Prthm-G/Single-Axis-MEMS-Accelerometer/FEA/Static and Modal Analysis/MEMS_1-Static 3-1.docx

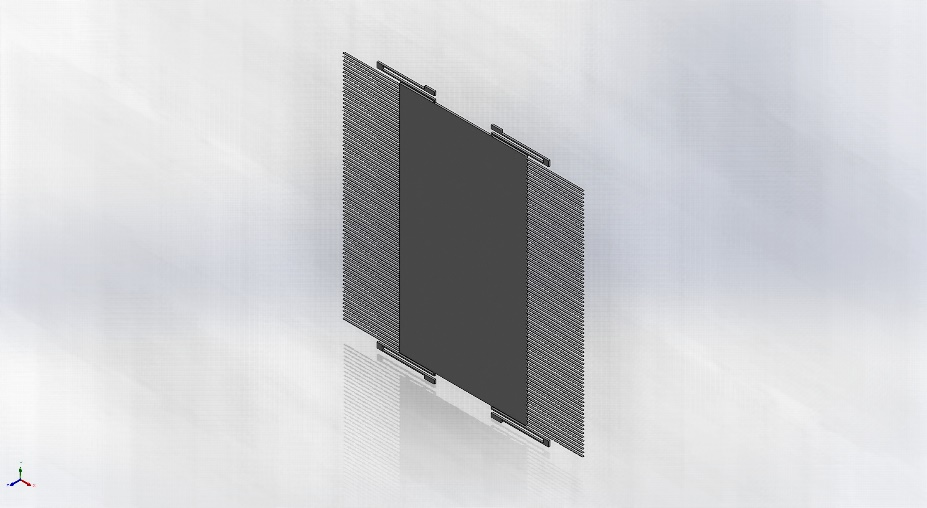
[picture p1: figure]

Simulation of MEMS_1

Date: Monday, December 4, 2023
Designer: Solidworks

Study name: Static 3

Analysis type: Static
Description No Data

# Assumptions

# Model Information

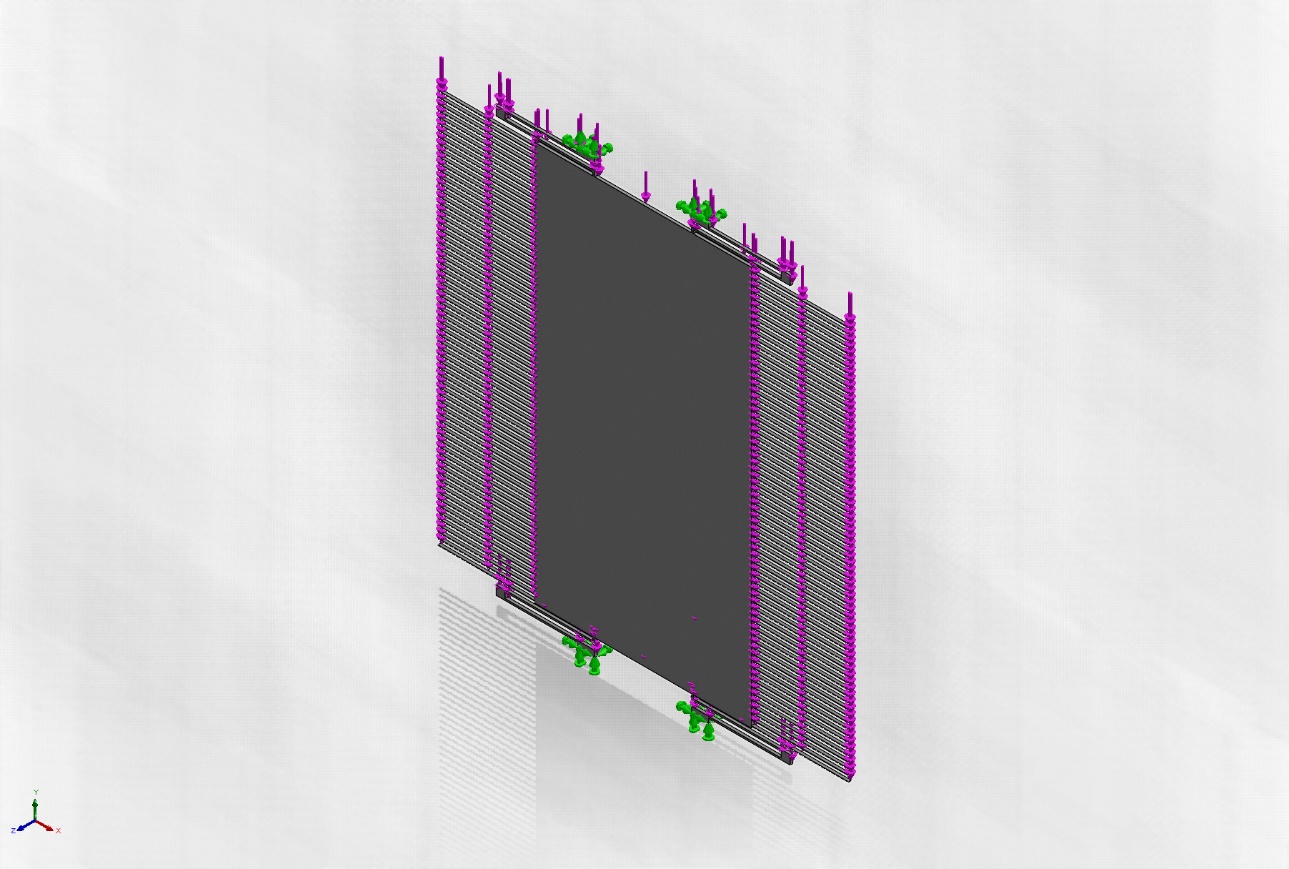
[picture p2: figure]

Model name: MEMS_1

Current Configuration: Default

Solid Bodies
Document Name and Reference | Treated As | Volumetric Properties | Document Path/Date Modified
MEMS_1.dwg<1> | Solid Body | Mass:4.30502e-10 kg Volume:1.84765e-10 m^3 Density:2.33 kg/m^3 Weight:4.21892e-09 N | C:\Users\241pr\OneDrive - UBC\Desktop\Apps\UBC\ELEC 465\Project\FEA\MEMS_1.SLDPRT Dec 4 13:18:33 2023

# Study Properties

Study name | Static 3
Analysis type | Static
Mesh type | Solid Mesh
Thermal Effect: | On
Thermal option | Include temperature loads
Zero strain temperature | 298 Kelvin
Include fluid pressure effects from SOLIDWORKS Flow Simulation | Off
Solver type | Automatic
Inplane Effect: | Off
Soft Spring: | Off
Inertial Relief: | Off
Incompatible bonding options | Automatic
Large displacement | Off
Compute free body forces | On
Friction | Off
Use Adaptive Method: | Off
Result folder | SOLIDWORKS document (C:\Users\241pr\OneDrive - UBC\Desktop\Apps\UBC\ELEC 465\Project\FEA)

# Units

Unit system: | SI (MKS)
Length/Displacement | mm
Temperature | Kelvin
Angular velocity | Rad/sec
Pressure/Stress | N/m^2

# Material Properties

Model Reference | Properties | Components

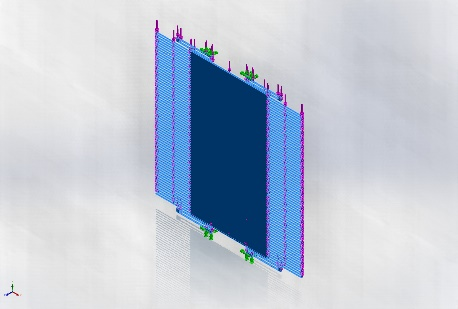
[picture p3: figure]

| Name: Custom Plastic Model type: Linear Elastic Isotropic Default failure criterion: Unknown Elastic modulus: 1.7e+11 N/m^2 Poisson's ratio: 0.29 Mass density: 2.33 kg/m^3 Thermal expansion coefficient: 2.6e-06 /Kelvin | SolidBody 1(MEMS_1.dwg<1>)(MEMS_1)

Curve Data:N/A

# Loads and Fixtures

Fixture name | Fixture Image | Fixture Details

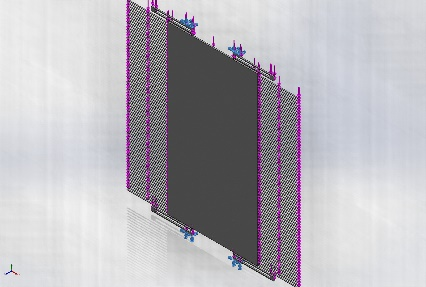
[picture p4: figure]

Fixed-1 | | Entities: 4 face(s) Type: Fixed Geometry

Resultant Forces

Components | X | Y | Z | Resultant
Reaction force(N) | 2.78533e-12 | 9.81e-06 | 1.25056e-12 | 9.81e-06
Reaction Moment(N.m) | 0 | 0 | 0 | 0

Load name | Load Image | Load Details

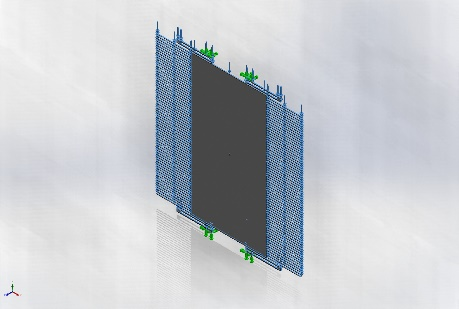
[picture p5: figure]

Force-1 | | Entities: 1 face(s) Type: Apply force Values: ---, -9.81e-06, --- N

# Connector Definitions

No Data

# Interaction Information

No Data

# Mesh information

Mesh type | Solid Mesh
Mesher Used: | Blended curvature-based mesh
Jacobian points for High quality mesh | 16 Points
Maximum element size | 0.00363897 in
Minimum element size | 0.00363897 in
Mesh Quality | High

## Mesh information - Details

Total Nodes | 41336
Total Elements | 17143
Maximum Aspect Ratio | 54.758
% of elements with Aspect Ratio < 3 | 5.69
Percentage of elements with Aspect Ratio > 10 | 53.5
Percentage of distorted elements | 0
Time to complete mesh(hh;mm;ss): | 00:00:13
Computer name: | RAZER-BLADE

# Sensor Details

No Data

# Resultant Forces

## Reaction forces

Selection set | Units | Sum X | Sum Y | Sum Z | Resultant
Entire Model | N | 2.78533e-12 | 9.81e-06 | 1.25056e-12 | 9.81e-06

## Reaction Moments

Selection set | Units | Sum X | Sum Y | Sum Z | Resultant
Entire Model | N.m | 0 | 0 | 0 | 0

## Free body forces

Selection set | Units | Sum X | Sum Y | Sum Z | Resultant
Entire Model | N | -2.27041e-11 | 1.85319e-09 | 8.51558e-12 | 1.85335e-09

## Free body moments

Selection set | Units | Sum X | Sum Y | Sum Z | Resultant
Entire Model | N.m | 0 | 0 | 0 | 1e-33

# Beams

No Data

# Study Results

Name | Type | Min | Max
Stress1 | VON: von Mises Stress | 1.122e+00N/m^2 Node: 27919 | 8.623e+05N/m^2 Node: 905

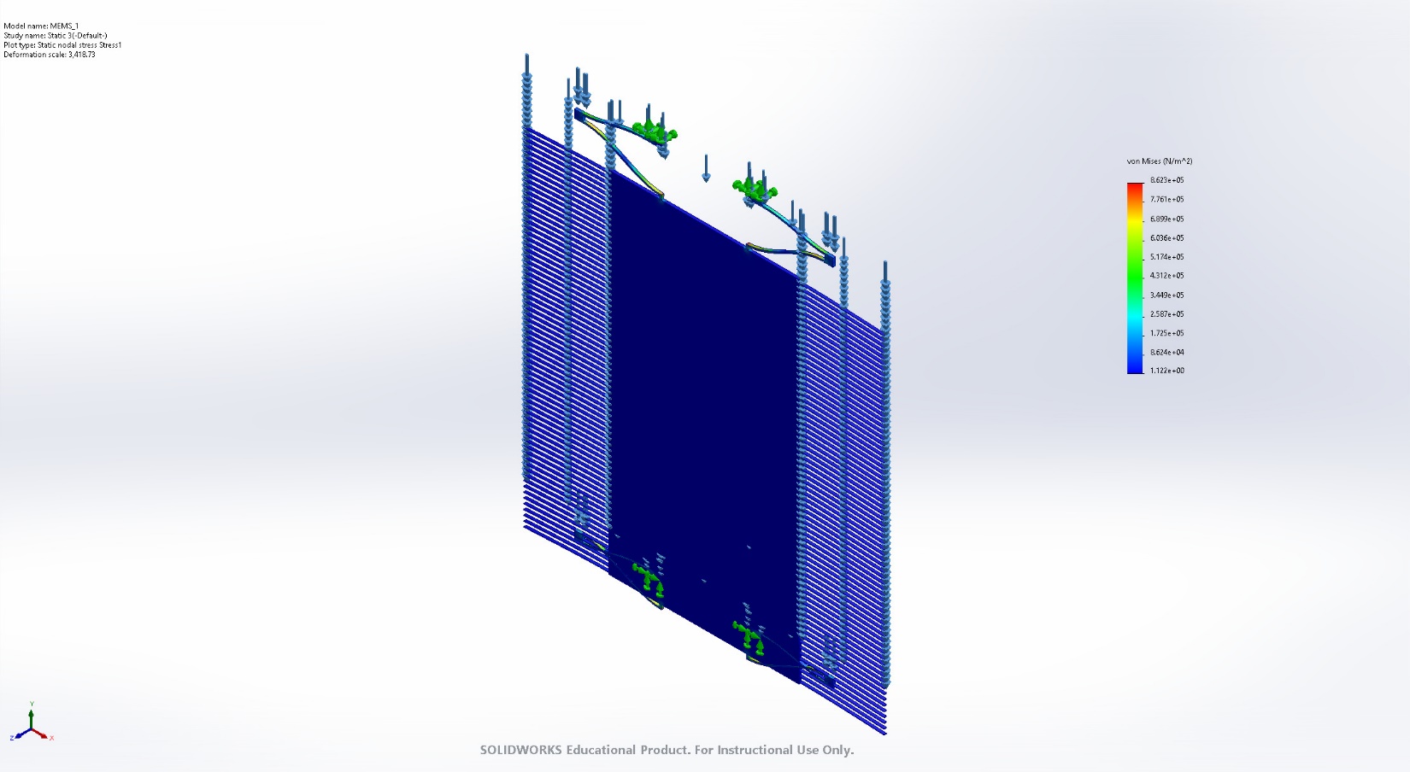
[picture p6: figure]

MEMS_1-Static 3-Stress-Stress1

Name | Type | Min | Max
Displacement1 | URES: Resultant Displacement | 0.000e+00mm Node: 8 | 1.112e-04mm Node: 579

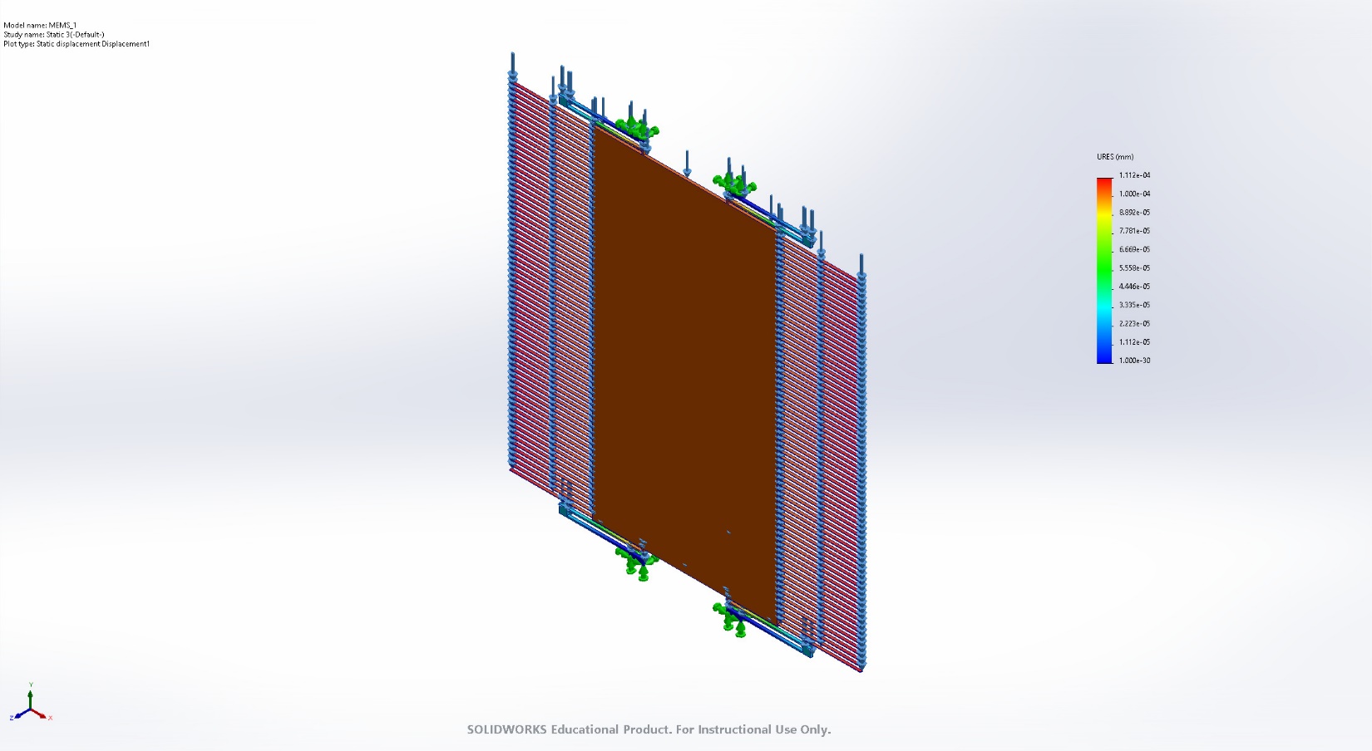
[picture p7: figure]

MEMS_1-Static 3-Displacement-Displacement1

Name | Type | Min | Max
Strain1 | ESTRN: Equivalent Strain | 5.837e-12 Element: 14689 | 2.776e-06 Element: 4347

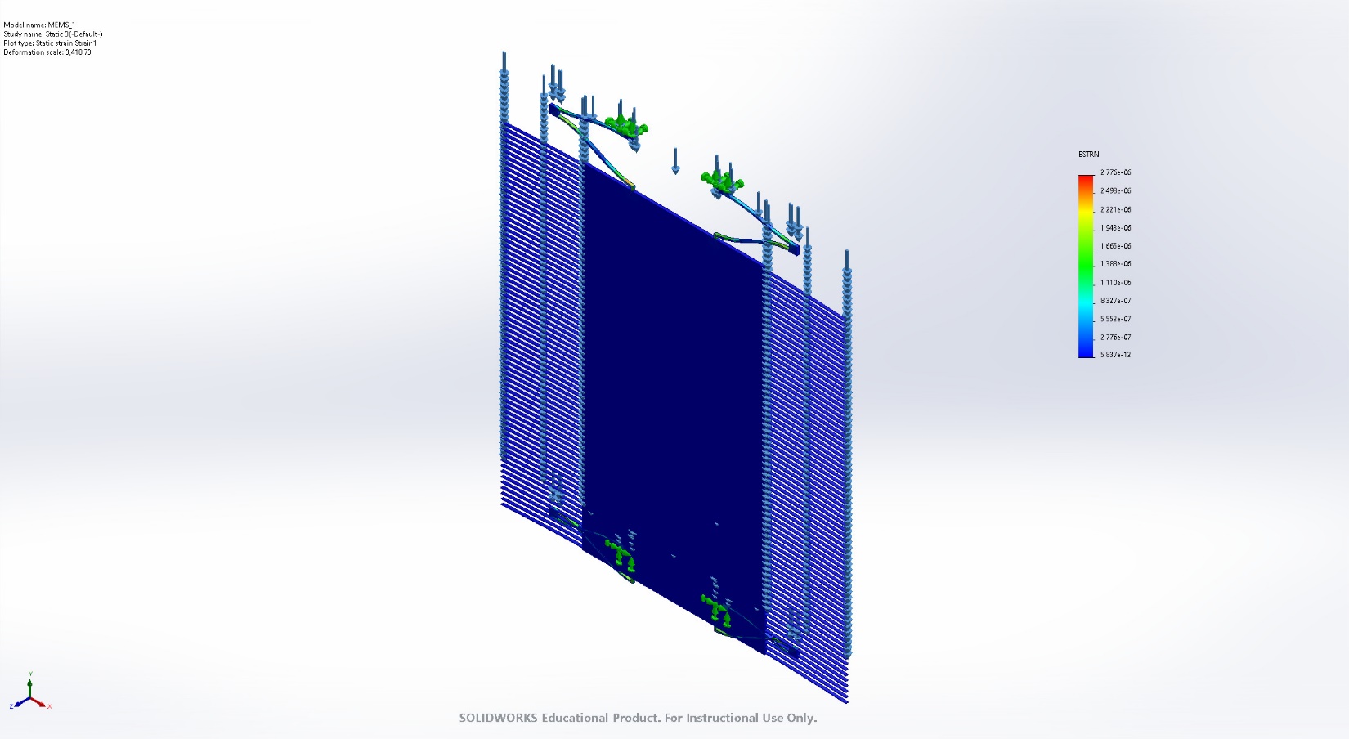
[picture p8: figure]

MEMS_1-Static 3-Strain-Strain1

Name | Type
Displacement1{1} | Deformed shape

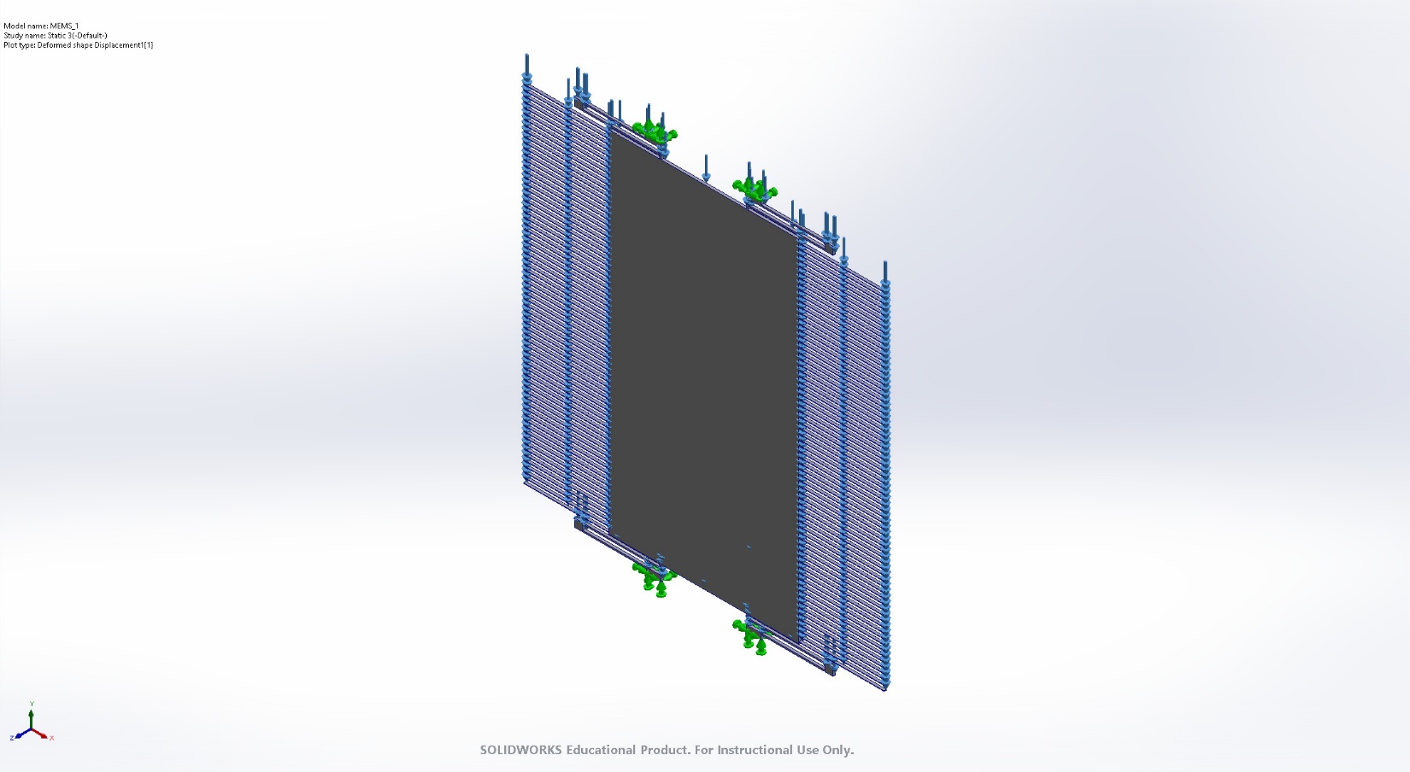
[picture p9: figure]

MEMS_1-Static 3-Displacement-Displacement1{1}

# Conclusion

Analyzed with SOLIDWORKS Simulation Simulation of MEMS_1 16

Analyzed with SOLIDWORKS Simulation Simulation of MEMS_1 1
