Prthm-G/Single-Axis-MEMS-Accelerometer/Simulink Scripts and Models/nonlinear_spring.jpg

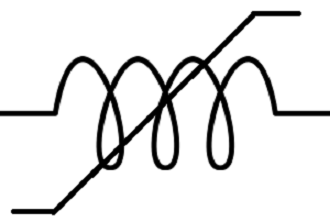
Simulink Scripts and Models/nonlinear_spring.jpg
