Prthm-G/Single-Axis-MEMS-Accelerometer/FEA/Design/FEA_Model.stp

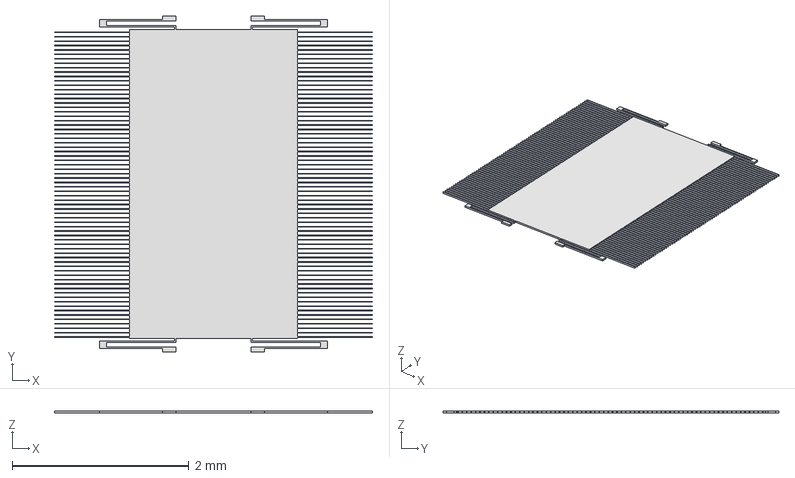
[picture p33: CAD file, 2023-12-10]
FEA/Design/FEA_Model.stp
3.60 x 3.80 x 0.025 mm
