Prthm-G/Single-Axis-MEMS-Accelerometer/3D Model/3D Model.stp

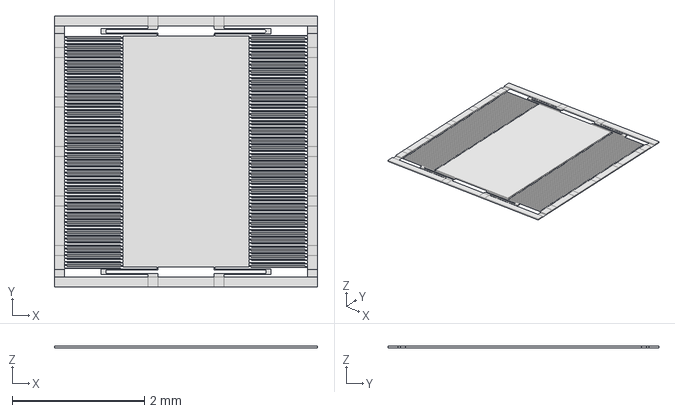
[picture p34: CAD file, 2023-12-10]
3D Model/3D Model.stp
3.98 x 4.10 x 0.0257 mm
