Prthm-G/Single-Axis-MEMS-Accelerometer/(list of files, cad)

Other CAD files:
3D Model/Single_Axis_MEMS_Accelerometer_fea.dwg
3D Model/FEA_Model.step
3D Model/FEA_Model/FEA_Model.ipt
